Foxynya/Frequency-tester-on-attyni84/README.md

# Frequency-tester-on-attyni84
Полностью готовый для производства проект частотного тестера на базе чипа attiny84. В проекте есть код программы, разводка печатной платы, а также техническая документация .

Список компонентов для сборки

Qty	  Item	              Value	      Size	Typical parts
2	    Ceramic capacitor	  12pF	      0805	As required by crystal
1	    Ceramic capacitor	  100nF	      0805	 
1	    SMD resistor	      220Ω	      0805	5%
1	    SMD resistor	      6.8kΩ	      0805	5%
1	    SMD resistor	      24kΩ	      0805	5%
2	    SMD resistor	      4.7kΩ	      0805	5%
1	    Microcontroller	    ATtiny84	  SOIC	ATtiny84A-SSF
2	    Schottky Diodes	    MBR0520	    SOD-123	MBR0520LT1G Schottky Rectifier 20V 500mA
1	    SMD Pushbutton	 	 	Mini Pushbutton Switch - SMD
1	    Crystal	            12MHz	      5x3.2mm	ABM3BAIG-12.000MHz-12-4-T Abracon Crystal 12MHz SMD
1	    OLED display I2C                128 x 32	0.91"	0.91 inch 128x32 I2C IIC Serial OLED LCD Display Module
1	    Lipo cell cell	    3.7V	      12mm x 15mm	401215 Lipo 3.7V 40mAh 1S
1	    PCB	Double-sided	              58.5 x 12.8mm
