Foxynya/Frequency-tester-on-attyni84/Тех паспорт.pdf

Тамбовский государственный технический университет

Кафедра «РАДИОТЕХНИКА»

Технический паспорт устройства

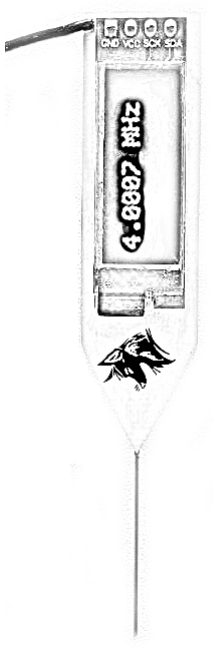
[picture p1: figure]

Частотный пробник ЛЧП-2.0

г. Тамбов 2023

Частотный пробник ЛЧП-2.0 | Радиотехника

Содержание
1. Назначение | 3
2. Технические характеристики | 3
3. Климатические условия | 4
4. Массогабаритные характеристики | 4
5. Комплектность изделия | 4

Частотный пробник ЛЧП-2.0 | Радиотехника

3

Назначение
Частотный пробник представляет собой ничто иное, как частотомер очень компактных размеров, который может пригодиться в отладке как самодельных плат, так и в настройке заводских плат после ремонта.
К преимуществам можно отнести:
- Компактные габариты устройства
- Высокая скорость определения частоты
- Простоту конструкции
Устройство имеет три режима работы – два как частотомер и один, как вольтметр. Первый режим работы (частотный) - устройство подсчитывает количество импульсов в течении одной секунды и выводит результат на экран, для удобства оператора. Второй режим (импульсный) заключается в измерении интервала между двумя импульсами входного сигнала, обратная величина этого значения дает нам частоту, которую пробник также выведет на экран для удобства оператора.

Технические характеристики

- Тип: Пробник;
- Питающее напряжение: 3,7В;
- Потребляемый ток: 10 мА;
- Диапазон измеряемых частот: 1Гц – 5MГц;
- Амплитуда измеряемого сигнала: 0.1В – 5В;
- Опорная частота: 12МГц;
- Время измерения: 1-3 сек;
- Количество значащих цифр: 5;
- Погрешность измерения: не более 0,3-0,5% (зависит от частотного диапазона, в котором работает устройство в режиме измерения);

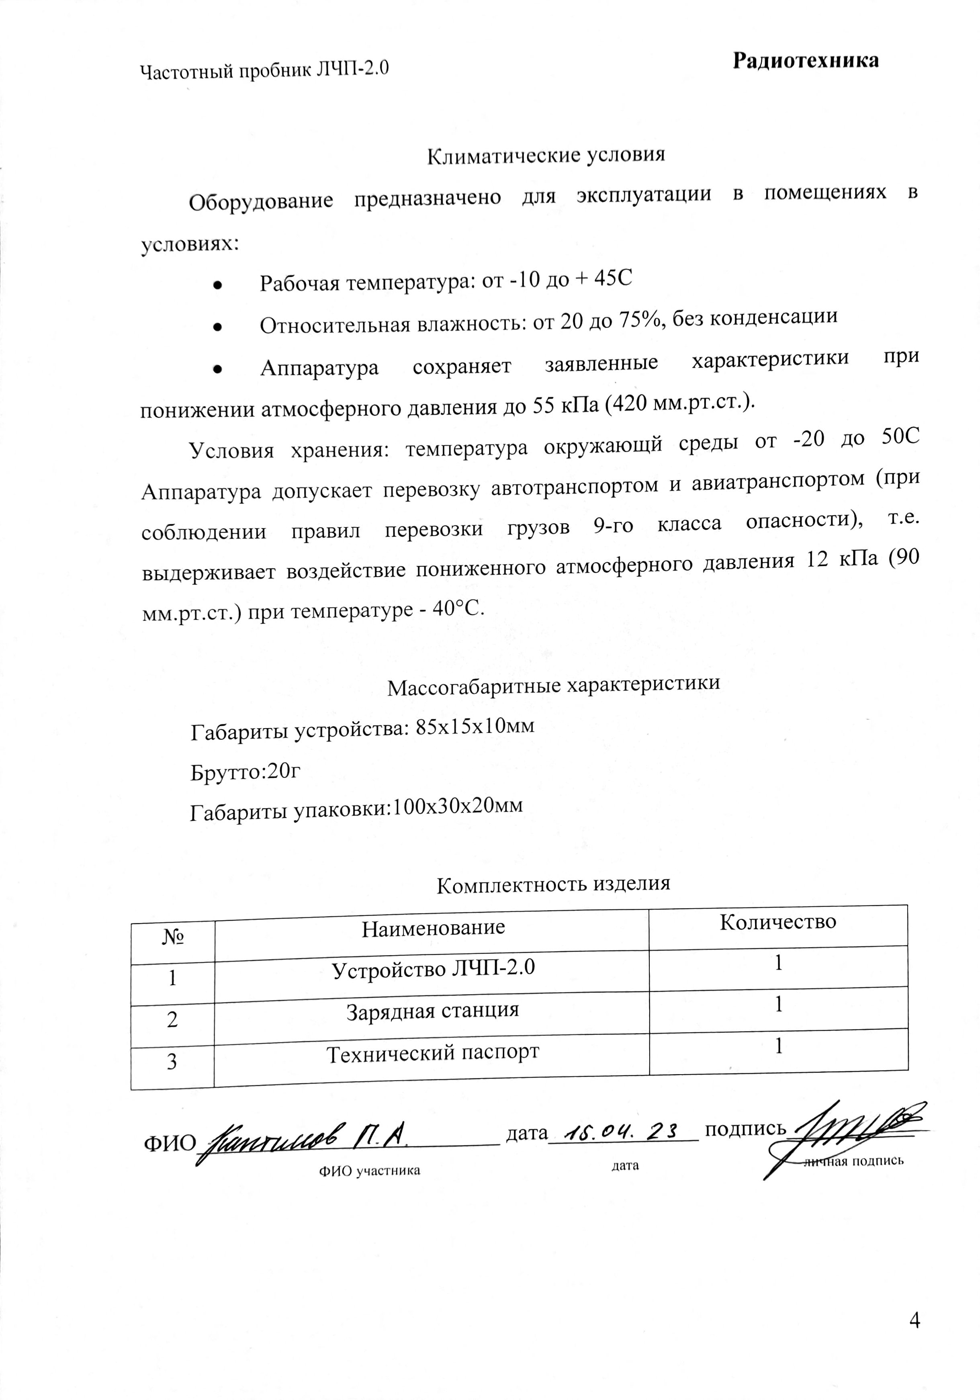
[picture p2: page 4]
