Foxynya/Frequency-tester-on-attyni84/frequencyprobe.gif

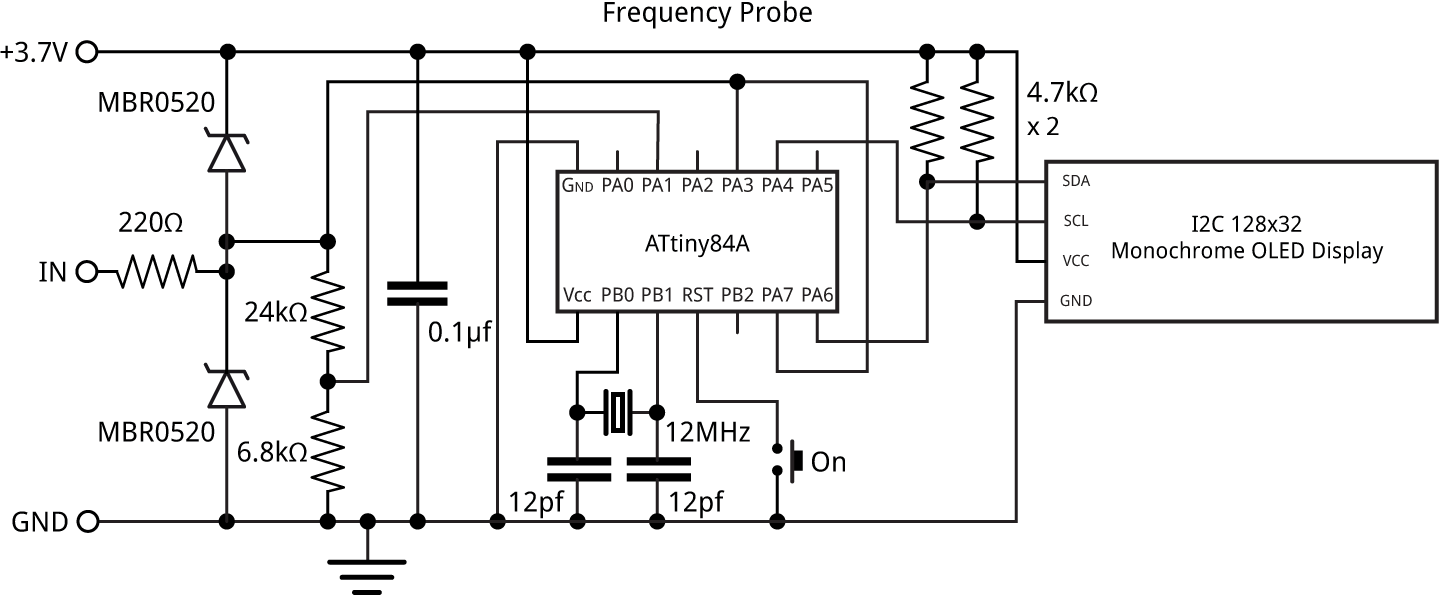
frequencyprobe.gif
