Foxynya/Frequency-tester-on-attyni84/(list of files, drawings)

Other design files:
fricvensy tester_V2.1.dip
